hanebuechenes/synapsMULT/production/V0.1/bom.csv

Designator | Footprint | Quantity | Value | LCSC Part #
C10, C11, C14, C15, C16, C7 | 0603 | 6 | 100nF 50V X7R
C12, C8 | CP_Elec_6.3x7.7 | 2 | 100uF 25V
C13, C9 | 0805 | 2 | 10uF 25V X7R
D1, D2 | D_SMA-SMB_Universal_Handsoldering | 2 | MBRA140T3G
D3, D4, D5, D6 | led-3mm | 4 | LED_Dual_Bidirectional
F1, F2 | 1210 | 2 | Polyfuse
FB1, FB2 | 0603 | 2 | 120R@100MHz 2A
J1 | 3.5mm_tip_switch_thonkiconn | 1 | IN1
J10, J13, J16, J7 | 3.5mm_tip_switch_thonkiconn | 4 | OUT3
J11, J14, J5, J8 | 3.5mm_tip_switch_thonkiconn | 4 | OUT1
J12, J15, J6, J9 | 3.5mm_tip_switch_thonkiconn | 4 | OUT2
J17 | PinHeader_2x05_P2.54mm_Vertical | 1 | Eurorack Header
J2 | 3.5mm_tip_switch_thonkiconn | 1 | IN2
J3 | 3.5mm_tip_switch_thonkiconn | 1 | IN3
J4 | 3.5mm_tip_switch_thonkiconn | 1 | IN4
R1, R10, R11, R12, R2, R3, R4, R5, R6, R7, R8, R9 | 0603 | 12 | 1k
R13, R14, R15, R16 | 0603 | 4 | 3,3k
U1 | DIP-14_W7.62mm | 1 | TL074
