hanebuechenes/synapsMULT/mult_panel-User_Drawings.dxf

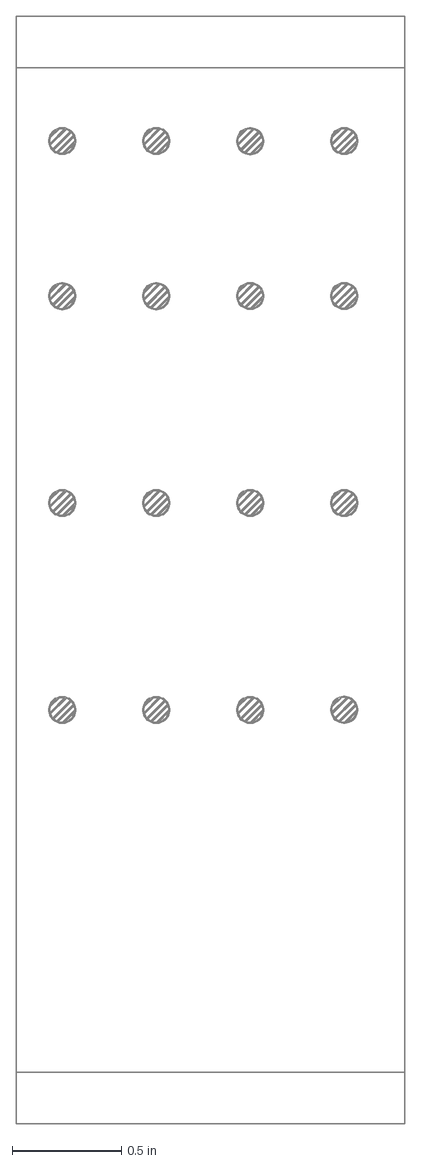
[picture p1: CAD file, 2026-11-06]
mult_panel-User_Drawings.dxf
1.78 x 5.06 in
