hanebuechenes/synapsMULT/synapsMULT_Panel3D-Cut.3mf

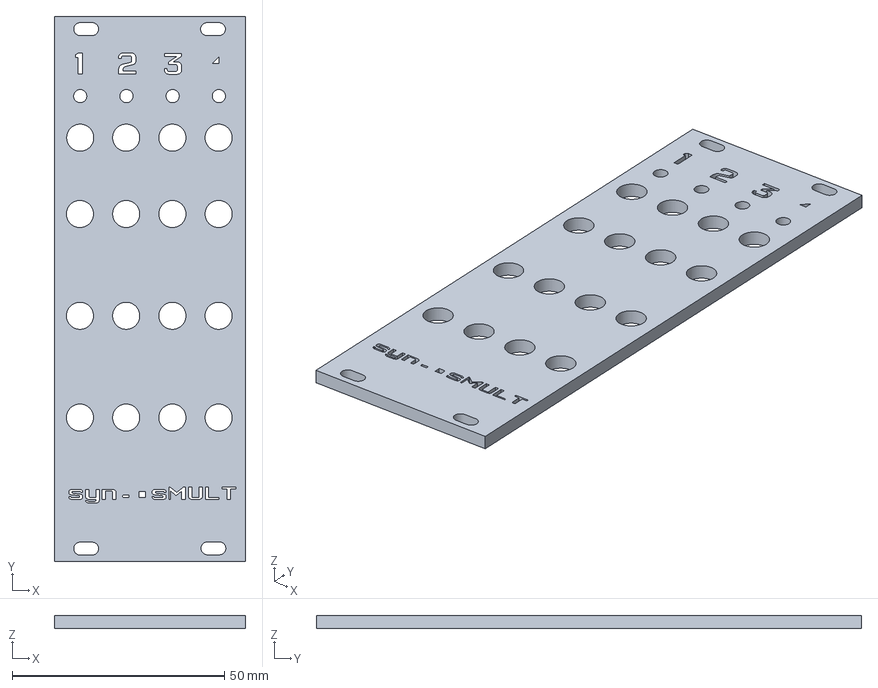
[picture p2: CAD file, 2026-11-06]
synapsMULT_Panel3D-Cut.3mf
45.1 x 128.5 x 3.00 mm
