hanebuechenes/synapsMULT/mult_panel-Edge_Cuts.dxf

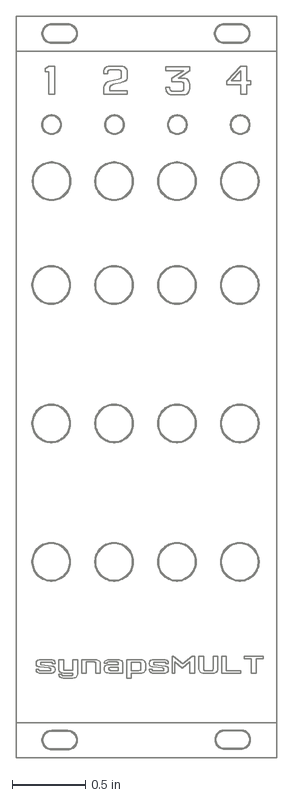
[picture p3: CAD file, 2026-11-06]
mult_panel-Edge_Cuts.dxf
1.78 x 5.06 in
