hanebuechenes/synapsMULT/(list of files, cad)

Other CAD files:
synapsMULT_Panel3D.FCStd
