hanebuechenes/synapsMULT/synapsMULT_panel.kicad_pcb

## KiCad design synapsMULT_panel.kicad_pcb (2026-11-06)

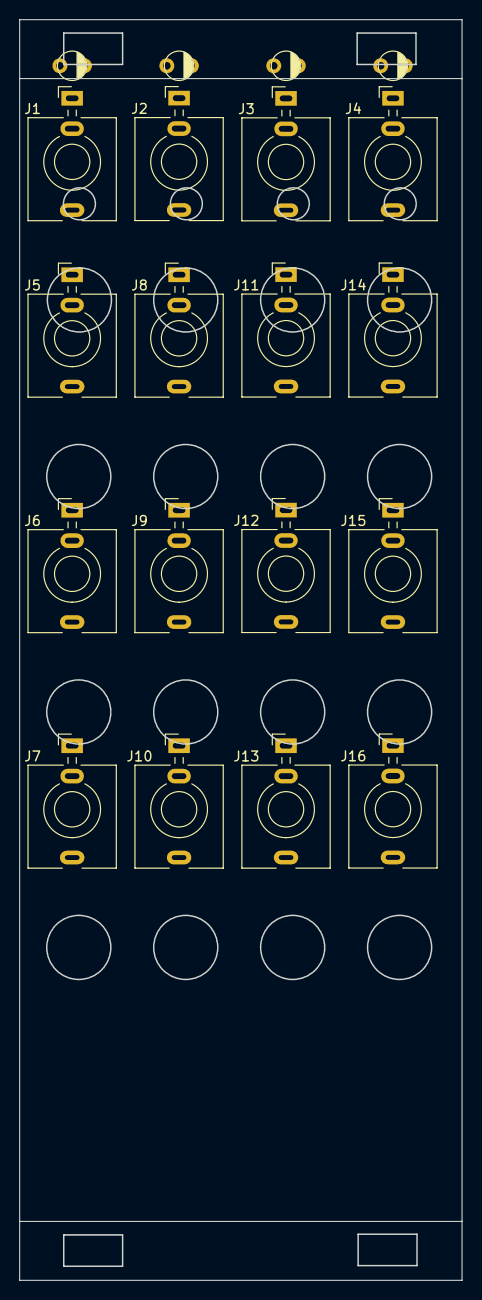
[picture p4: board synapsMULT_panel.kicad_pcb from above]

Board: 2 copper layers, 45.1 x 128.5 mm, 20 parts (0 on the bottom side), 4 nets, no tracks yet.

Parts:
D3, D4, D5, D6: LED_Dual_Bidirectional; led-3mm
J1: IN1; 3.5mm_tip_switch_thonkiconn
J2: IN2; 3.5mm_tip_switch_thonkiconn
J3: IN3; 3.5mm_tip_switch_thonkiconn
J4: IN4; 3.5mm_tip_switch_thonkiconn
J5, J8, J11, J14: OUT1; 3.5mm_tip_switch_thonkiconn
J6, J9, J12, J15: OUT2; 3.5mm_tip_switch_thonkiconn
J7, J10, J13, J16: OUT3; 3.5mm_tip_switch_thonkiconn

Connections:
GND: J1.S, J2.S, J3.S, J4.S, J5.S, J6.S, J7.S, J8.S, J9.S, J10.S, J11.S, J12.S, J13.S, J14.S, J15.S, J16.S
unnamed: J1.T, J2.TN
unnamed: J3.T, J4.TN
unnamed: J2.T, J3.TN
