hanebuechenes/synapsMULT/synapsMULT.kicad_pcb

## KiCad design synapsMULT.kicad_pcb (2026-11-06)

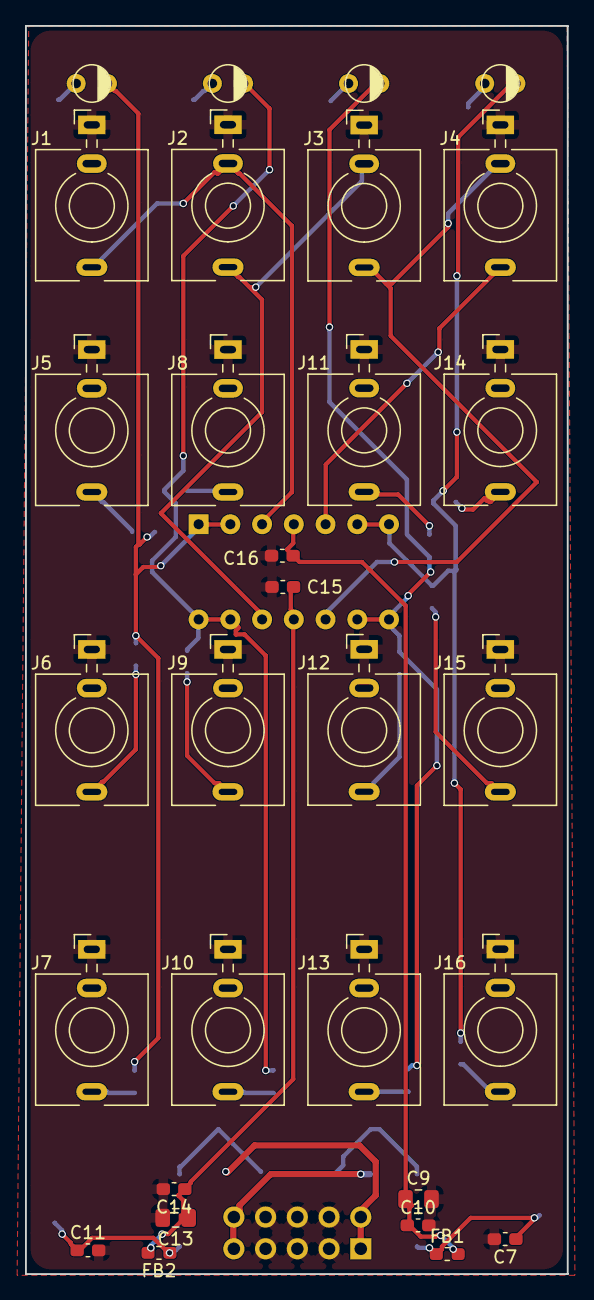
[picture p5: board synapsMULT.kicad_pcb from above]

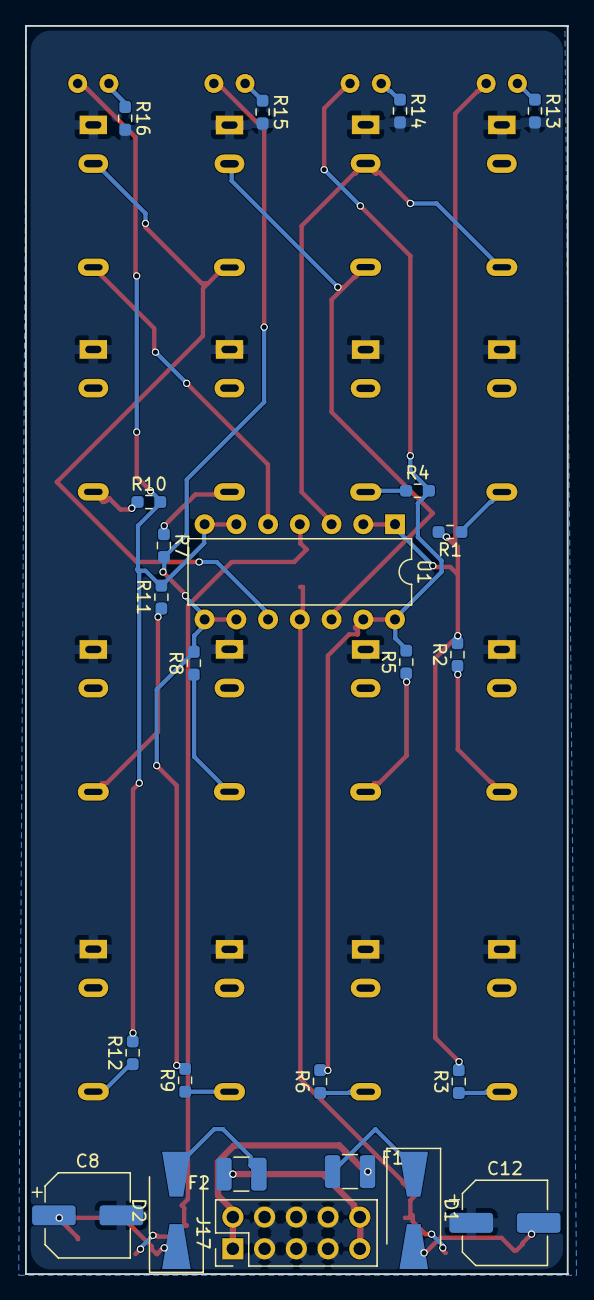
[picture p6: board synapsMULT.kicad_pcb from below]

Board: 2 copper layers, 43.4 x 99.9 mm, 54 parts (24 on the bottom side), 33 nets.

Parts:
C7, C10, C11, C14, C15, C16: 100nF 50V X7R; C_0603_1608Metric_Pad1.08x0.95mm_HandSolder
C8, C12: 100uF 25V; CP_Elec_6.3x7.7
C9, C13: 10uF 25V X7R; C_0805_2012Metric_Pad1.18x1.45mm_HandSolder
D1, D2: MBRA140T3G; D_SMA-SMB_Universal_Handsoldering
D3, D4, D5, D6: LED_Dual_Bidirectional; led-3mm
F1, F2: Polyfuse; Fuse_1210_3225Metric
FB1, FB2: 120R@100MHz 2A; L_0603_1608Metric_Pad1.05x0.95mm_HandSolder
J1: IN1; 3.5mm_tip_switch_thonkiconn
J2: IN2; 3.5mm_tip_switch_thonkiconn
J3: IN3; 3.5mm_tip_switch_thonkiconn
J4: IN4; 3.5mm_tip_switch_thonkiconn
J5, J8, J11, J14: OUT1; 3.5mm_tip_switch_thonkiconn
J6, J9, J12, J15: OUT2; 3.5mm_tip_switch_thonkiconn
J7, J10, J13, J16: OUT3; 3.5mm_tip_switch_thonkiconn
J17: Eurorack Header; PinHeader_2x05_P2.54mm_Vertical
R1, R2, R3, R4, R5, R6, R7, R8, R9, R10, R11, R12: 1k; R_0603_1608Metric_Pad0.98x0.95mm_HandSolder
R13, R14, R15, R16: 3,3k; R_0603_1608Metric_Pad0.98x0.95mm_HandSolder
U1: TL074; DIP-14_W7.62mm

Connections:
+12V: F2.1, J17.9, J17.10
+12VA: C9.1, C10.1, C16.1, FB1.2, U1.4 (V+)
+12V_RAW: C7.1, C8.1, D2.1 (K), FB1.1
-12V: F1.1, J17.1, J17.2
-12VA: C13.1, C14.1, C15.1, FB2.2, U1.11 (V-)
-12V_RAW: C11.1, C12.2, D1.2 (A), FB2.1
GND: C7.2, C8.2, C9.2, C10.2, C11.2, C12.1, C13.2, C14.2, C15.2, C16.2, J1.S, J2.S, J3.S, J4.S, J5.S, J6.S, J7.S, J8.S, J9.S, J10.S, J11.S, J12.S, J13.S, J14.S, J15.S, J16.S, J17.3, J17.4, J17.5, J17.6, J17.7, J17.8, R13.2, R14.2, R15.2, R16.2
unnamed: D1.1 (K), F1.2
unnamed: D2.2 (A), F2.2
unnamed: D3.2 (AK), R13.1
unnamed: D3.1 (KA), R1.2, R2.2, R3.2, U1.1, U1.2 (-)
unnamed: D4.2 (AK), R14.1
unnamed: D4.1 (KA), R4.2, R5.2, R6.2, U1.13 (-), U1.14
unnamed: D5.2 (AK), R15.1
unnamed: D5.1 (KA), R7.2, R8.2, R9.2, U1.8, U1.9 (-)
unnamed: D6.2 (AK), R16.1
unnamed: D6.1 (KA), R10.2, R11.2, R12.2, U1.6 (-), U1.7
unnamed: J5.T, R1.1
unnamed: J6.T, R2.1
unnamed: J7.T, R3.1
unnamed: J8.T, R4.1
unnamed: J9.T, R5.1
unnamed: J10.T, R6.1
unnamed: J11.T, R7.1
unnamed: J12.T, R8.1
unnamed: J13.T, R9.1
unnamed: J14.T, R10.1
unnamed: J15.T, R11.1
unnamed: J16.T, R12.1
unnamed: J1.T, J2.TN, U1.3 (+)
unnamed: J4.T, U1.5 (+)
unnamed: J3.T, J4.TN, U1.10 (+)
unnamed: J2.T, J3.TN, U1.12 (+)
